gerdj/RedBear/SFP_Extruder/Doc/BOM.pdf

SFP Extruder BOM

Item | QTY
Brass heat insert M3 x 5.7 | 5
Brass heat insert M2.5 x 5.7 | 2
M3 hex nut | 1
M3 square nut | 6
M3 nylock nut | 5
M2 x 8 BHCS screw | 1
M3 x 12 BHCS screw | 4
M3 x 20 BHCS screw | 2
M3 x 16 CS screw | 1
M2.5 x 6 SHCS screw | 2
M3 x 10 SHCS screw | 10
M3 x 18 SHCS screw | 4
M3 x 35 SHCS screw | 2
M3 x 40 SHCS screw | 2
M3 x 50 SHCS screw | 2
Bondtech ballbearing 5x8x2.5 SKU: MR85ZZ | 2
Bondtech shaft assembly SKU: 15021 | 1
Bondtech drivegear kit SKU: EXT-KIT33 | 1
Bondtech motorgear SKU: 15002B | 1
Bondtech thumbscrew SKU: 15026 | 1
PTFE tube >18mm | 1
Prusa i3 MK3 to MK3S upgrade kit Ref: MK3-MK3S-SELF | 1
Mosquito hotend assembled | 1
Nema 17 pancake stepper motor 20 or 25mm | 1
Fan 40x10x10 | 1
Fan blower 5015 | 1
