gerdj/RedBear/SFP_Extruder/CAD/STL/X_Carriage.stl

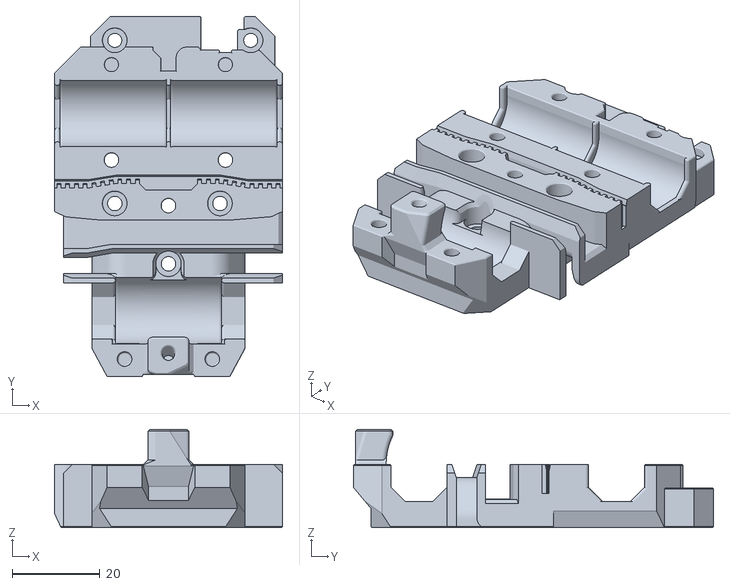
[picture p2: CAD file, 2020-08-03]
SFP_Extruder/CAD/STL/X_Carriage.stl
52.0 x 82.2 x 22.4
