gerdj/RedBear/SFP_Extruder/CAD/STL/Fan_Duct_32.stl

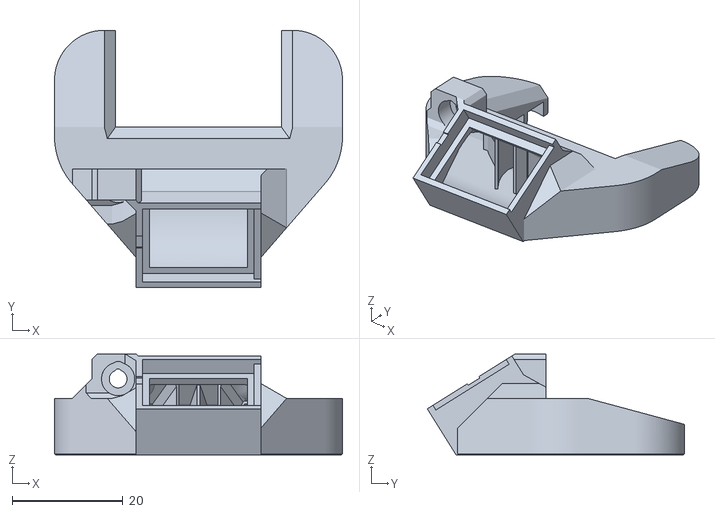
[picture p3: CAD file, 2020-08-03]
SFP_Extruder/CAD/STL/Fan_Duct_32.stl
52.0 x 46.5 x 18.2
