gerdj/RedBear/SFP_Extruder/CAD/STL/X_Carriage_Back.stl

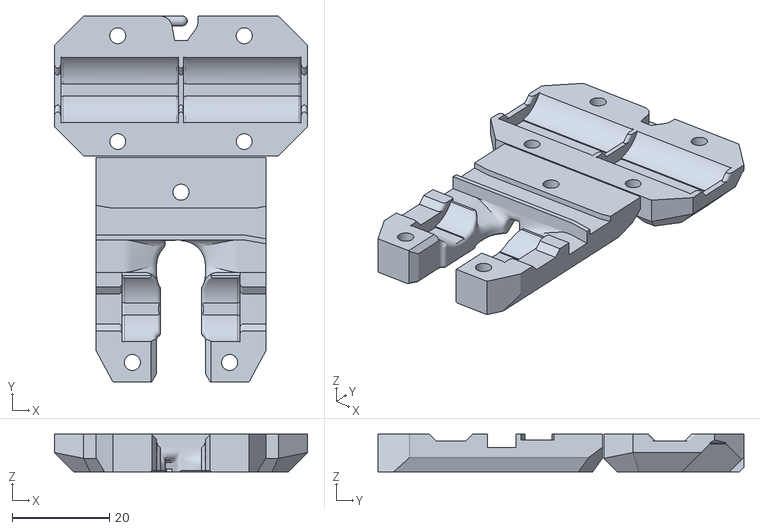
[picture p4: CAD file, 2020-08-03]
SFP_Extruder/CAD/STL/X_Carriage_Back.stl
52.0 x 75.2 x 7.80
