gerdj/RedBear/SFP_Extruder/CAD/STL/Adapter_printer.stl

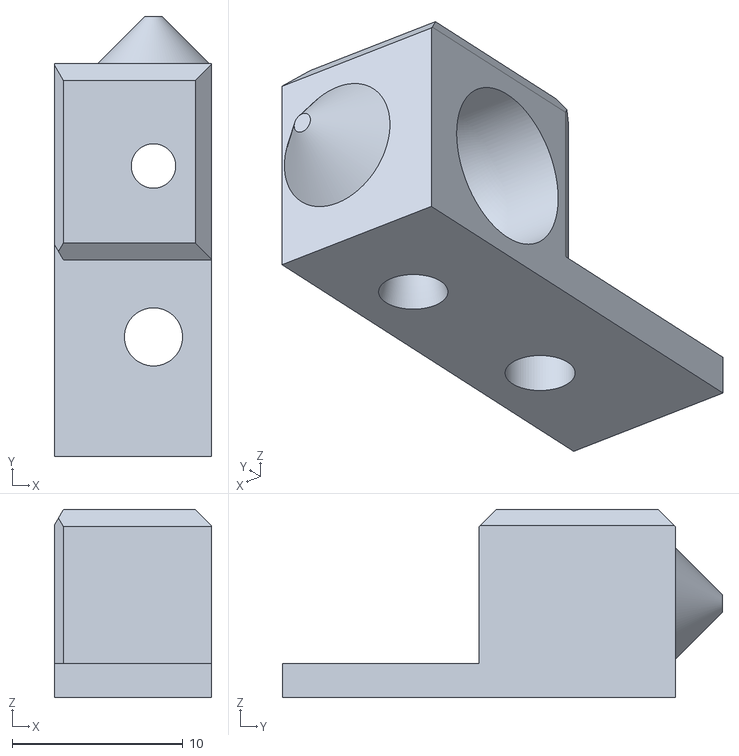
[picture p5: CAD file, 2020-08-03]
SFP_Extruder/CAD/STL/Adapter_printer.stl
9.20 x 25.8 x 11.0
