gerdj/RedBear/SFP_Extruder/CAD/STL/Extruder_Front.stl

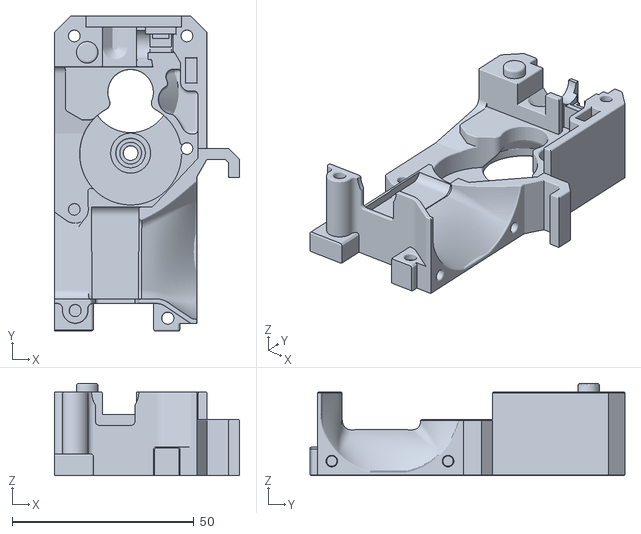
[picture p6: CAD file, 2020-08-03]
SFP_Extruder/CAD/STL/Extruder_Front.stl
51.0 x 86.7 x 25.4
