gerdj/RedBear/SFP_Extruder/CAD/STL/Cable_Guide_Back_A.stl

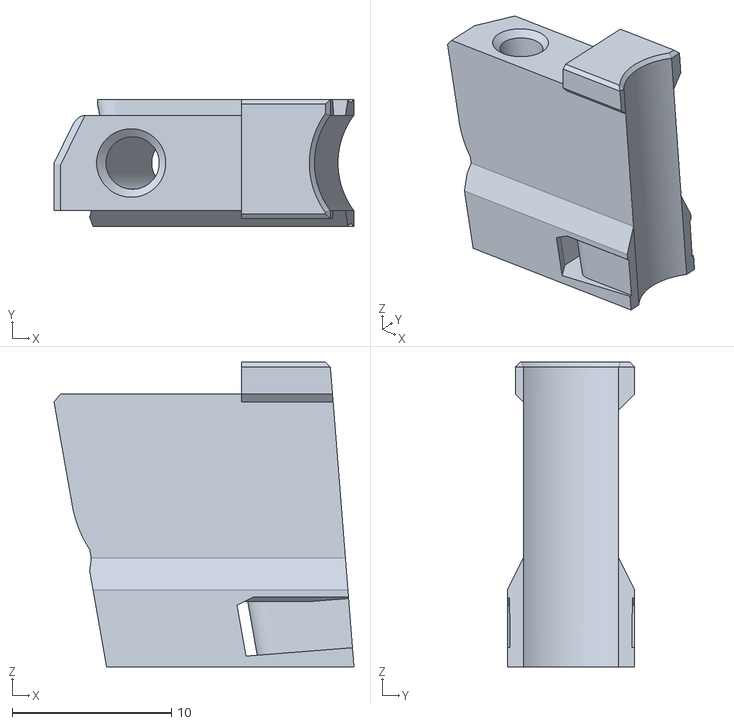
[picture p7: CAD file, 2020-08-03]
SFP_Extruder/CAD/STL/Cable_Guide_Back_A.stl
18.9 x 8.00 x 19.1
