gerdj/RedBear/SFP_Extruder/CAD/STL/FS_Cover_Rev_Bowden_M10.stl

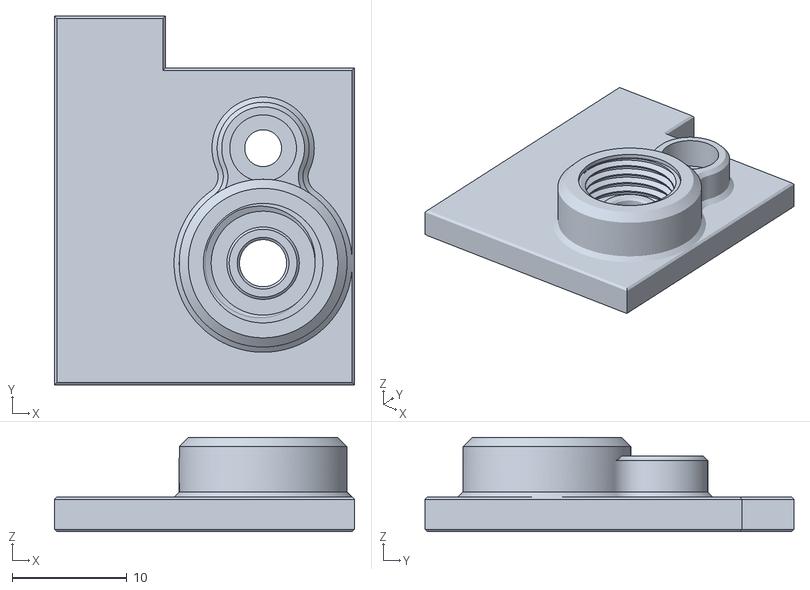
[picture p8: CAD file, 2020-08-03]
SFP_Extruder/CAD/STL/FS_Cover_Rev_Bowden_M10.stl
26.1 x 32.1 x 8.20
