gerdj/RedBear/SFP_Extruder/CAD/STL/Fan_Support_32.stl

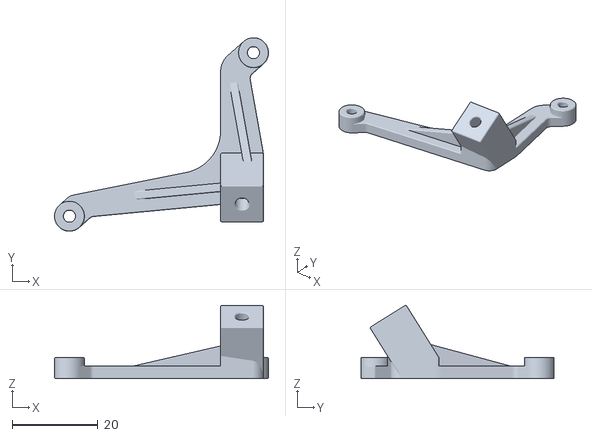
[picture p9: CAD file, 2020-08-03]
SFP_Extruder/CAD/STL/Fan_Support_32.stl
50.0 x 45.2 x 17.2
