gerdj/RedBear/SFP_Extruder/CAD/STL/FS_Cover.stl

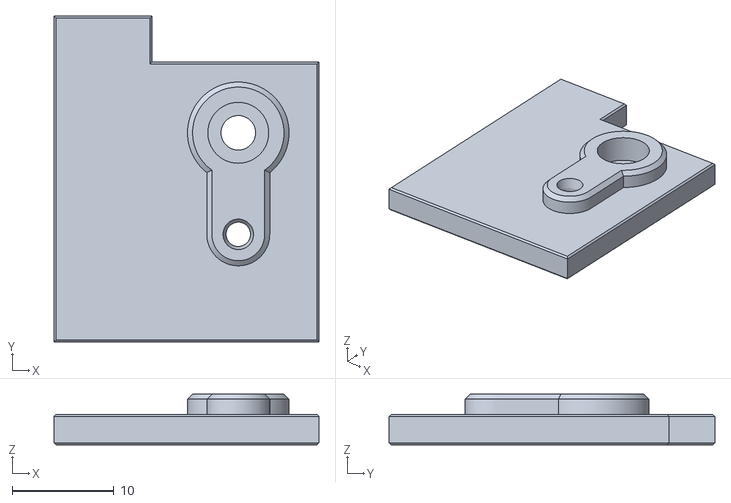
[picture p10: CAD file, 2020-08-03]
SFP_Extruder/CAD/STL/FS_Cover.stl
26.1 x 32.1 x 5.00
