gerdj/RedBear/SFP_Extruder/CAD/STL/FS_Lever.stl

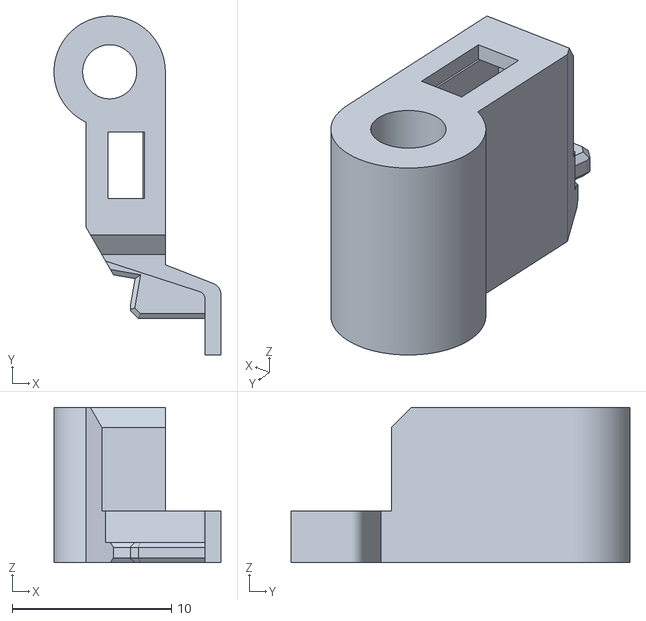
[picture p11: CAD file, 2020-08-03]
SFP_Extruder/CAD/STL/FS_Lever.stl
10.5 x 21.3 x 9.75
