gerdj/RedBear/SFP_Extruder/CAD/STL/Cable_Guide_Back_B.stl

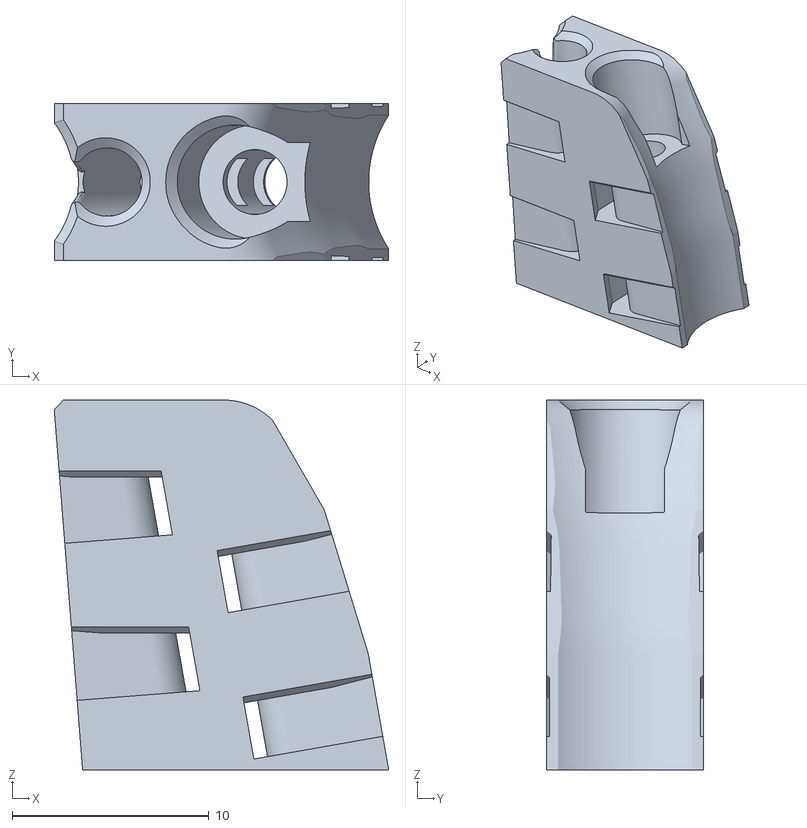
[picture p12: CAD file, 2020-08-03]
SFP_Extruder/CAD/STL/Cable_Guide_Back_B.stl
17.0 x 8.00 x 18.8
