gerdj/RedBear/SFP_Extruder/CAD/STL/Extruder_Idler.stl

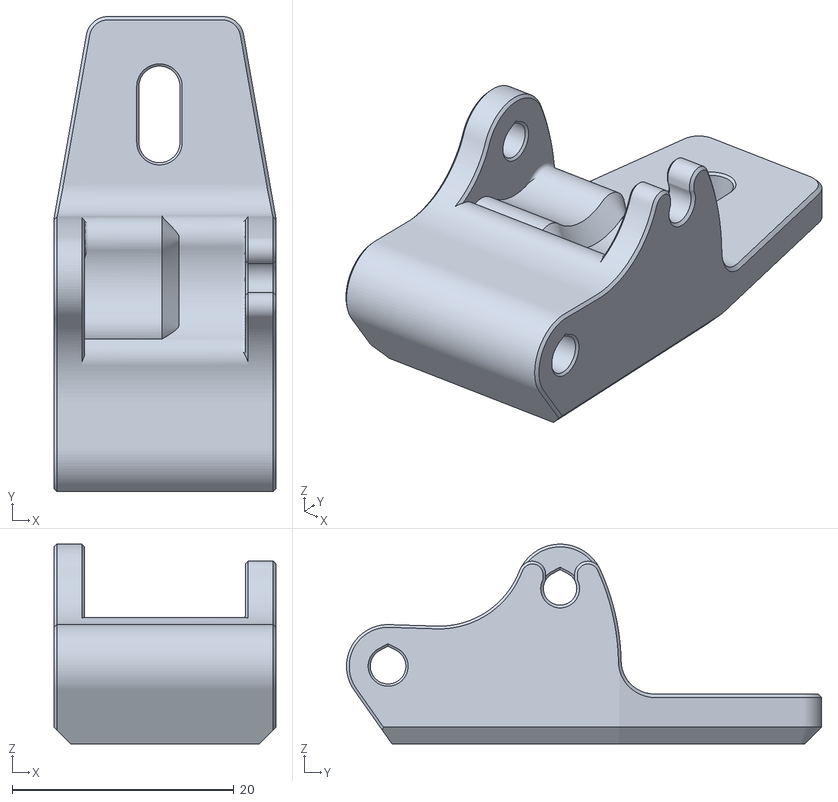
[picture p13: CAD file, 2020-08-03]
SFP_Extruder/CAD/STL/Extruder_Idler.stl
20.0 x 42.8 x 18.0
