gerdj/RedBear/SFP_Extruder/CAD/STL/Extruder_Base.stl

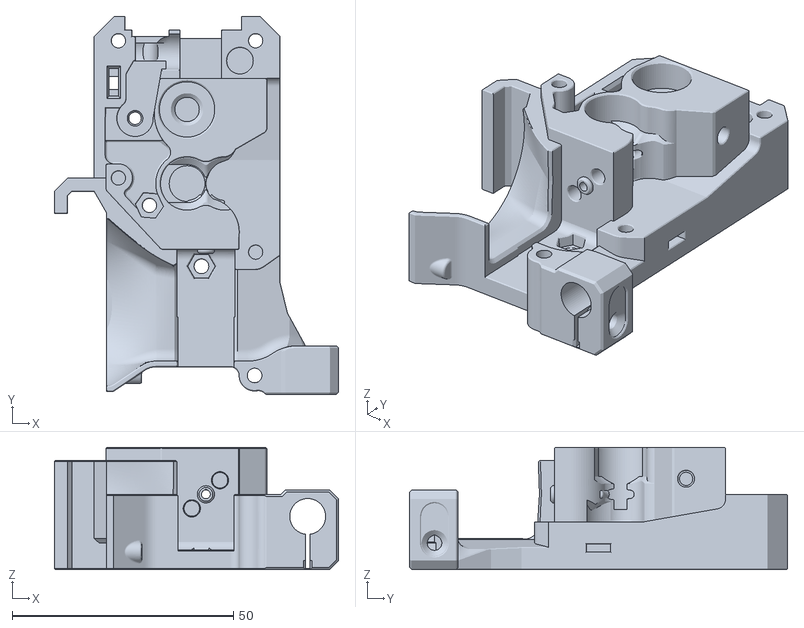
[picture p14: CAD file, 2020-08-03]
SFP_Extruder/CAD/STL/Extruder_Base.stl
64.2 x 85.4 x 27.6
