gerdj/RedBear/SFP_Extruder/Doc/SFP_Extruder_Assembly.pdf

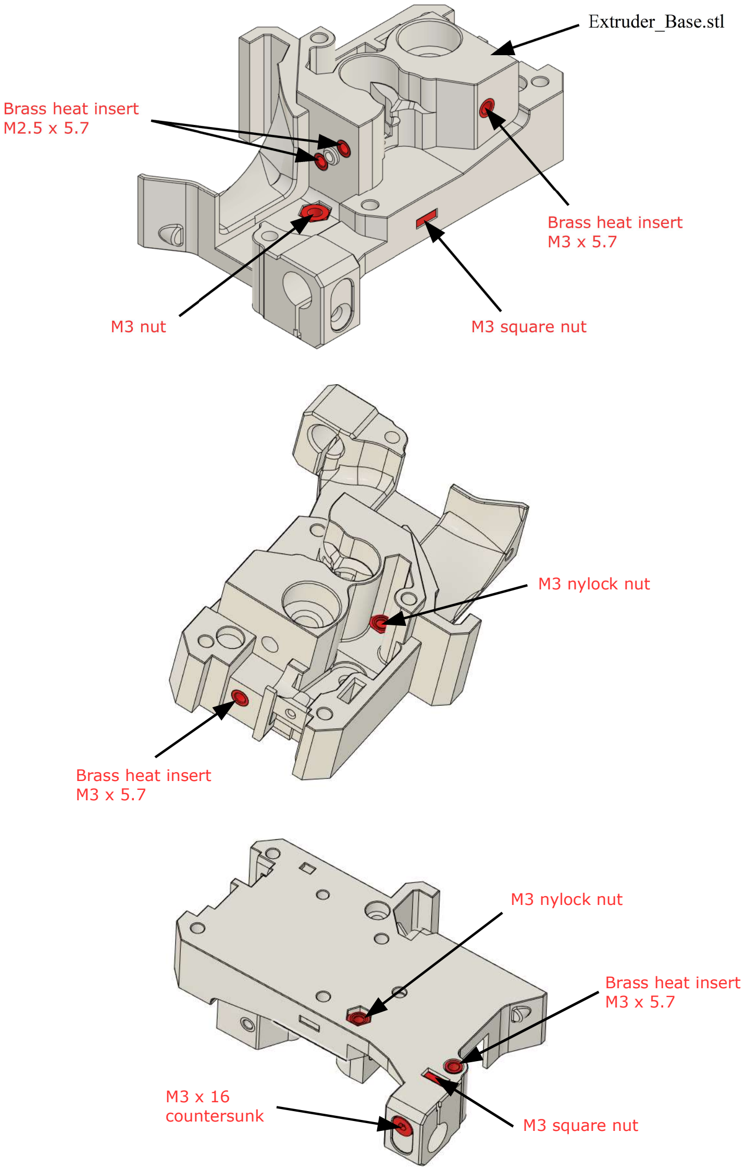
[picture p15: page 1]

Brass heat insert
M3 x 5.7

M3 nylock nut

M3 nylock nut

M3 x 16

countersunk | M3 square nut Brass heat insert
| M3 x 5.7

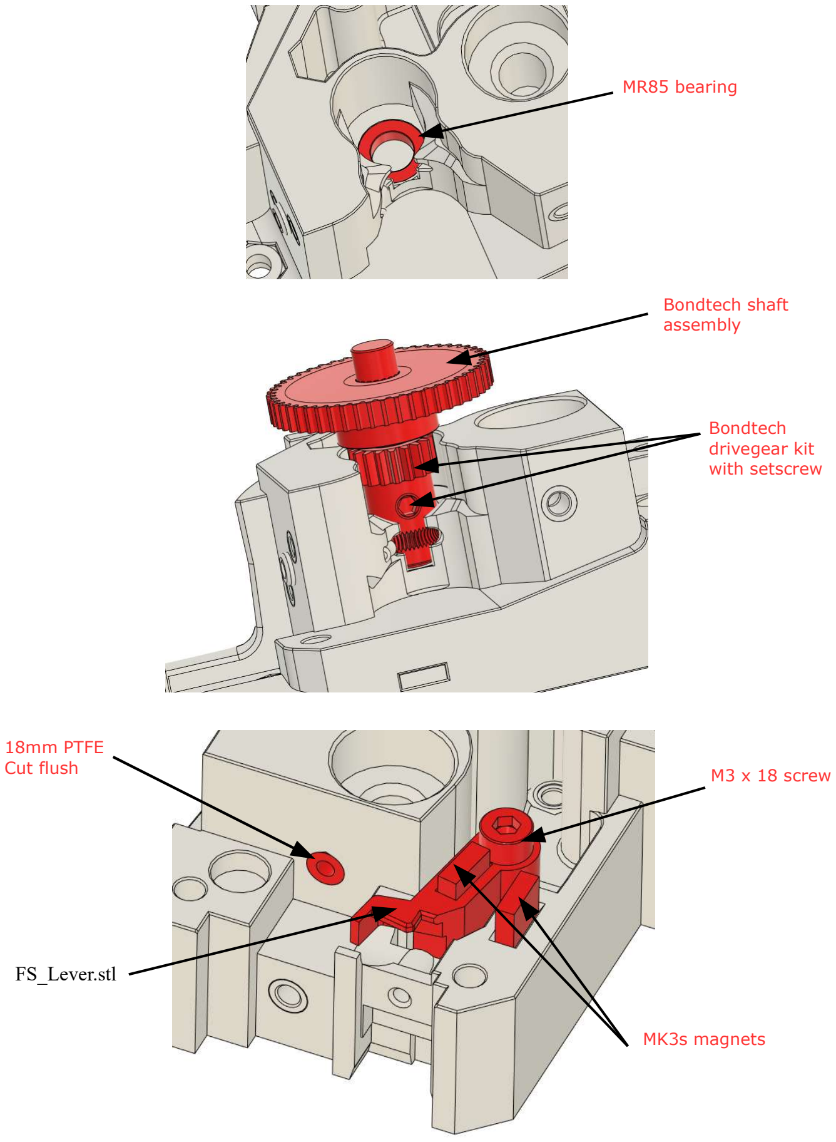
[picture p16: page 2]

MR85 bearing

Bondtech shaft
assembly

Bondtech
drivegear kit
with setscrew

M3 x 18 screw

MK3s magnets

18mm PTFE
Cut flush

FS_Lever.stl

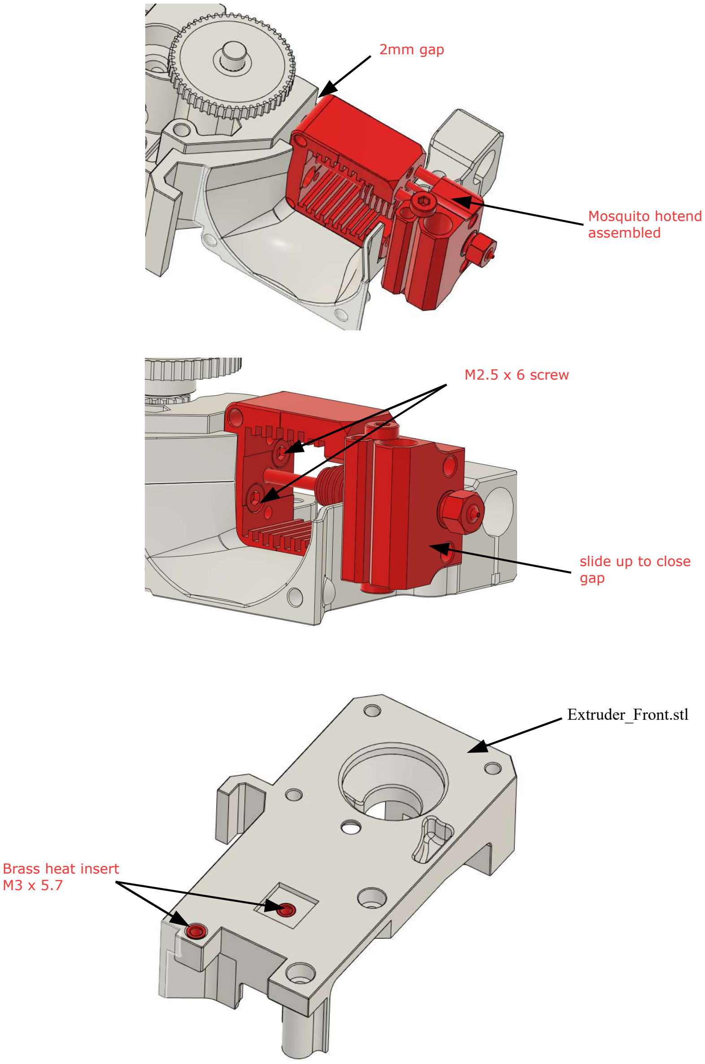
[picture p17: page 3]

Mosquito hotend
assembled

2mm gap

M2.5 x 6 screw

slide up to close
gap

Extruder_Front.stl

Brass heat insert
M3 x 5.7

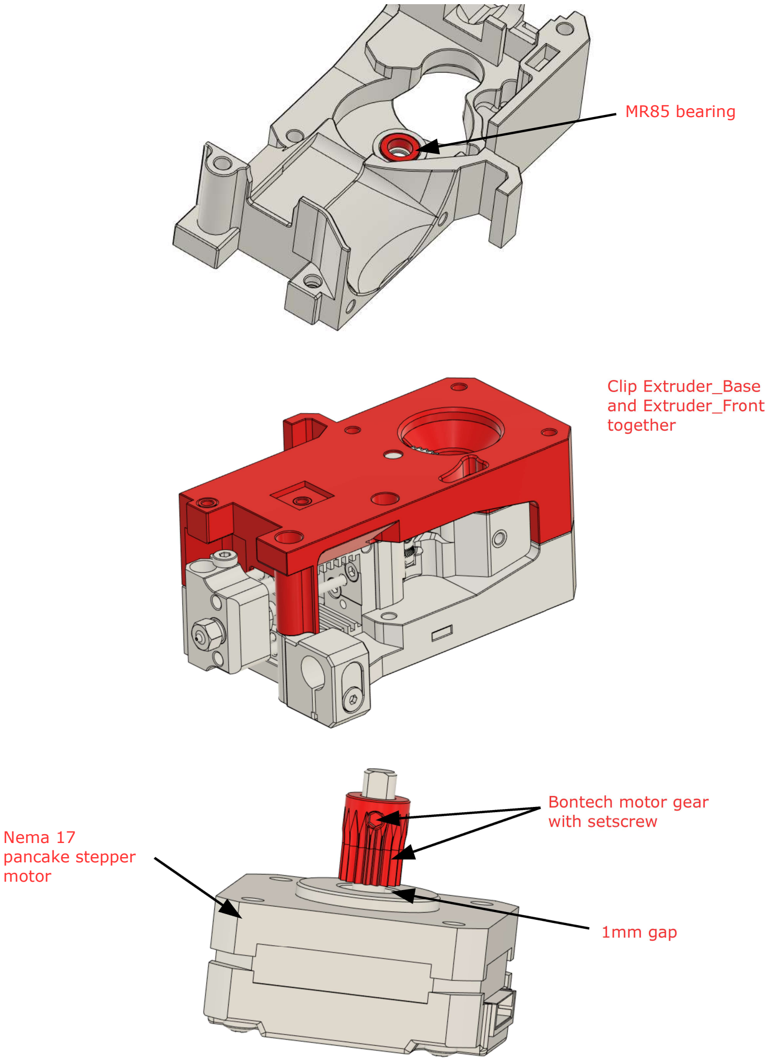
[picture p18: page 4]

MR85 bearing

Nema 17
pancake stepper
motor

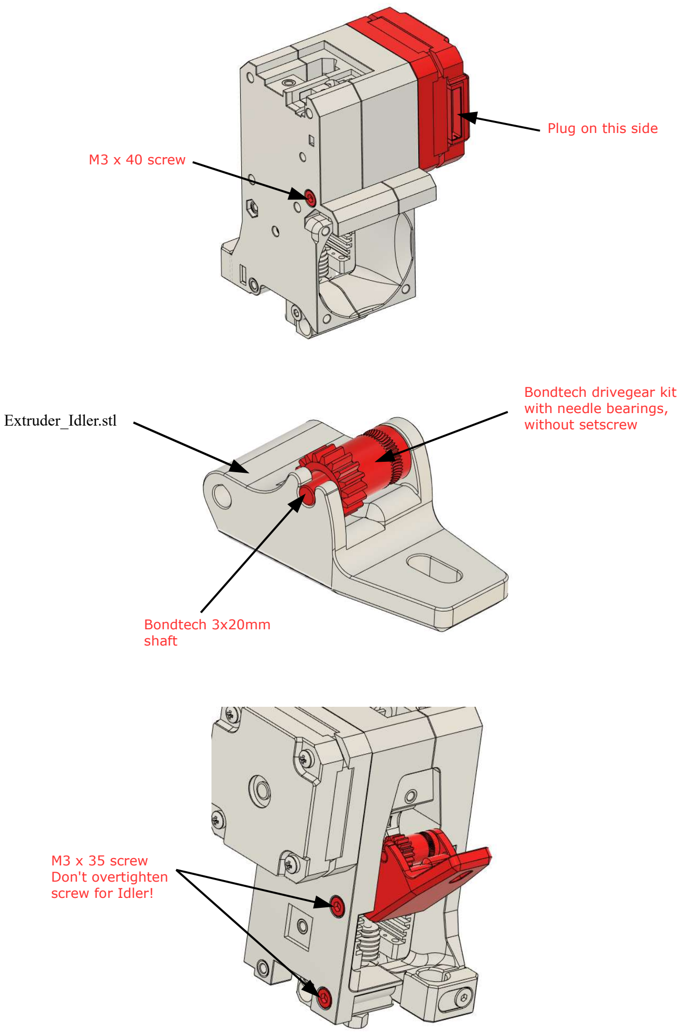
[picture p19: page 5]

Plug on this side

M3 x 40 screw

Extruder_Idler.stl

Bondtech drivegear kit
with needle bearings,
without setscrew

Bondtech 3x20mm
shaft

M3 x 35 screw
Don't overtighten
screw for Idler!

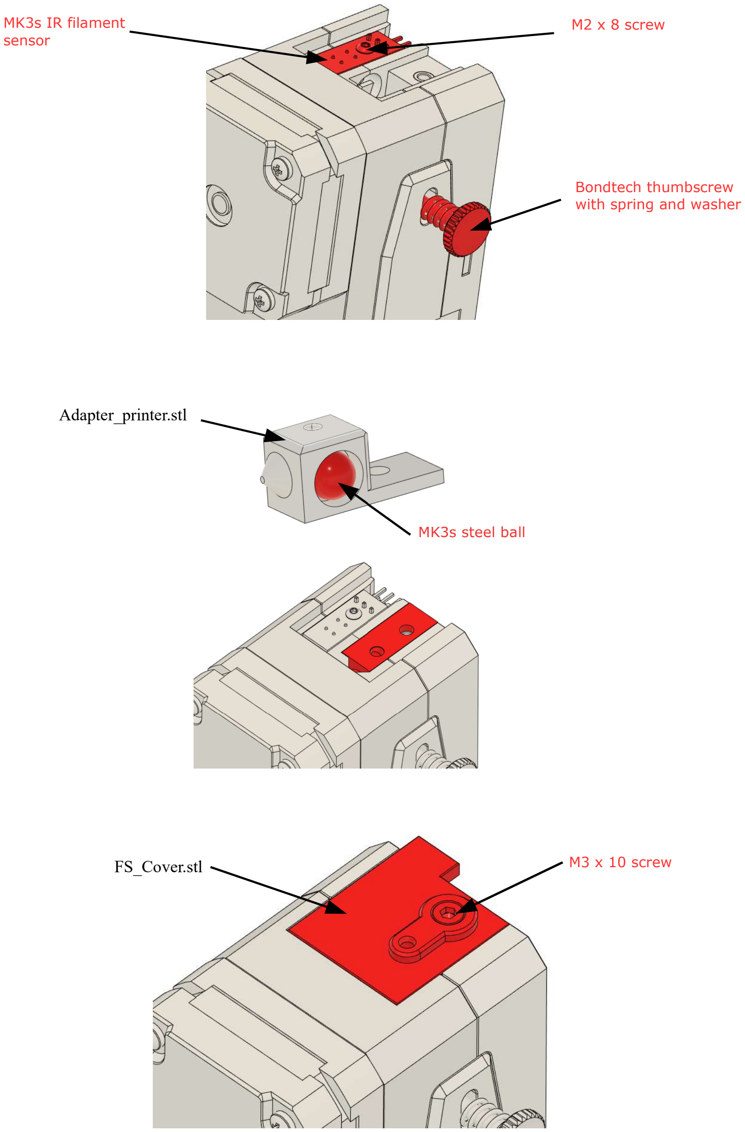
[picture p20: page 6]

MK3s IR filament
sensor

M2 x 8 screw

Bondtech thumbscrew
with spring and washer

Adapter_printer.stl

FS_Cover.stl | M3 x 10 screw

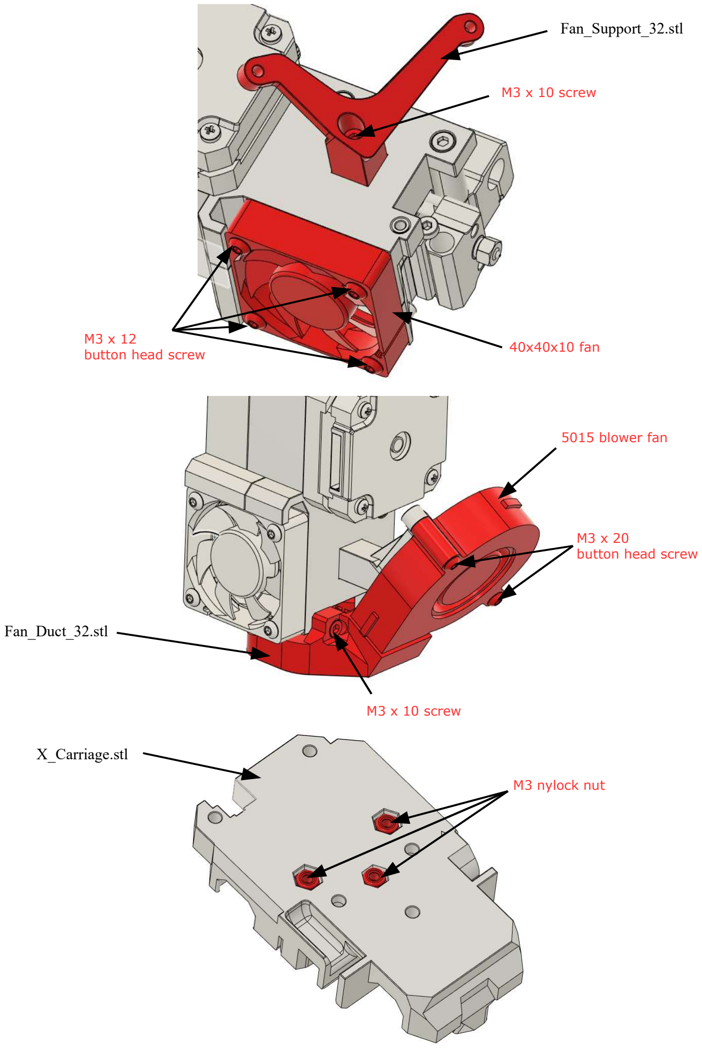
[picture p21: page 7]

Fan_Support_32.stl

M3 x 10 screw

M3 x 12
button head screw | 40x40x10 fan

Fan_Duct_32.stl

M3 x 20
button head screw

5015 blower fan

M3 x 10 screw

^

X_Carriage.stl

M3 nylock nut

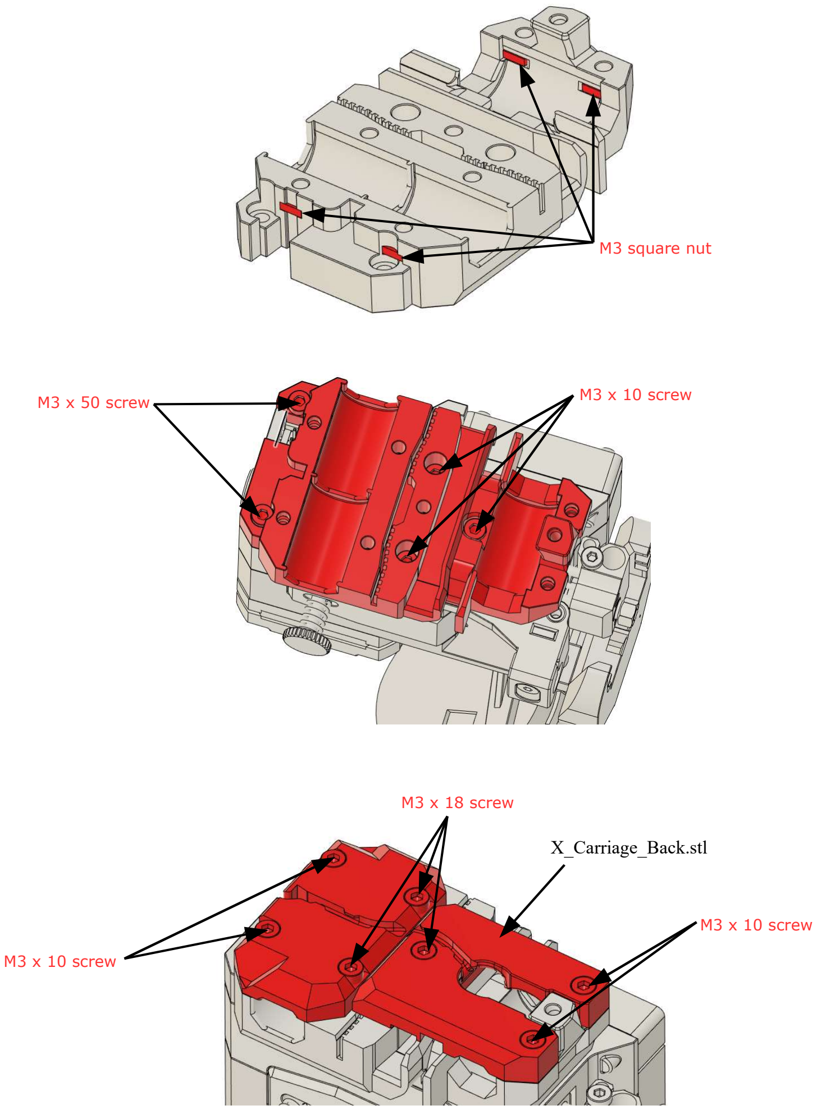
[picture p22: page 8]

M3 square nut

M3 x 10 screw M3 x 50 screw

M3 x 10 screw

M3 x 18 screw

X_Carriage_Back.stl

M3 x 10 screw

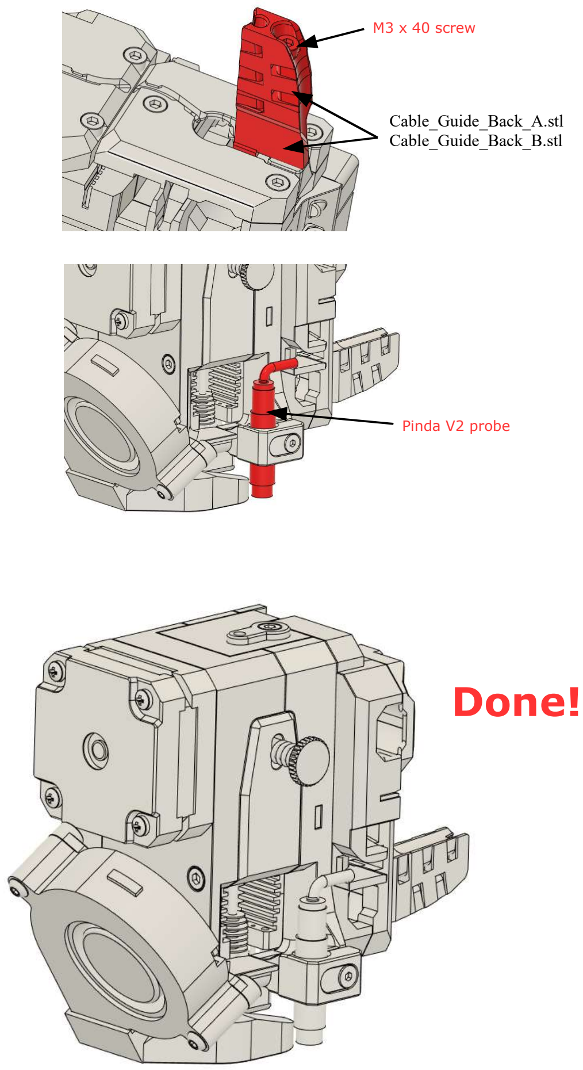
[picture p23: page 9]

M3 x 40 screw

Cable_Guide_Back_A.stl
Cable_Guide_Back_B.stl

Pinda V2 probe

# Done!
