gerdj/RedBear/Firmware/2.0.6/Marlin/Configuration_adv.h

#define E0_AUTO_FAN_PIN P2_04
#define E1_AUTO_FAN_PIN -1
#define E2_AUTO_FAN_PIN -1
#define E3_AUTO_FAN_PIN -1
#define E4_AUTO_FAN_PIN -1
#define E5_AUTO_FAN_PIN -1
#define E6_AUTO_FAN_PIN -1
#define E7_AUTO_FAN_PIN -1
#define CHAMBER_AUTO_FAN_PIN -1
#define HOMING_BUMP_MM      { 0, 0, 2 }       // (mm) Backoff from endstops after first bump
#define HOMING_BUMP_DIVISOR { 2, 2, 4 }       // Re-Bump Speed Divisor (Divides the Homing Feedrate)
#define HOMING_BACKOFF_POST_MM { 2, 2, 2 }  // (mm) Backoff from endstops after homing
#define QUICK_HOME                          // If G28 contains XY do a diagonal move first
  #define HOME_AFTER_G34
#define MICROSTEP_MODES { 16, 16, 16, 16, 16, 16 } // [1,2,4,8,16]
#define LIN_ADVANCE
  #define LIN_ADVANCE_K 0.00    // Unit: mm compression per 1mm/s extruder speed
#define ADVANCED_PAUSE_FEATURE
  #define ADVANCED_PAUSE_PURGE_FEEDRATE        3  // (mm/s) Extrude feedrate (after loading). Should be slower than load feedrate.
  #define ADVANCED_PAUSE_PURGE_LENGTH         30  // (mm) Length to extrude after loading.
  #define ADVANCED_PAUSE_RESUME_PRIME          0  // (mm) Extra distance to prime nozzle after returning from park.
  #define ADVANCED_PAUSE_FANS_PAUSE             // Turn off print-cooling fans while the machine is paused.
    #define X_CURRENT       500        // (mA) RMS current. Multiply by 1.414 for peak current.
    #define X_CURRENT_HOME  200  // (mA) RMS current for sensorless homing
    #define X_MICROSTEPS     16    // 0..256
    #define Y_CURRENT       600
    #define Y_CURRENT_HOME  250
    #define Y_MICROSTEPS     16
    #define Z_CURRENT       450
    #define Z_CURRENT_HOME  Z_CURRENT
    #define Z_MICROSTEPS     16
    #define Z2_CURRENT      450
    #define Z2_CURRENT_HOME Z2_CURRENT
    #define Z2_MICROSTEPS    16
    #define E0_CURRENT      550
    #define E0_MICROSTEPS    32
  #define X_HYBRID_THRESHOLD     100  // [mm/s]
  #define X2_HYBRID_THRESHOLD    100
  #define Y_HYBRID_THRESHOLD     100
  #define Y2_HYBRID_THRESHOLD    100
  #define Z_HYBRID_THRESHOLD       3
  #define Z2_HYBRID_THRESHOLD      3
  #define Z3_HYBRID_THRESHOLD      3
  #define Z4_HYBRID_THRESHOLD      3
  #define E0_HYBRID_THRESHOLD     30
  #define E1_HYBRID_THRESHOLD     30
  #define E2_HYBRID_THRESHOLD     30
  #define E3_HYBRID_THRESHOLD     30
  #define E4_HYBRID_THRESHOLD     30
  #define E5_HYBRID_THRESHOLD     30
  #define E6_HYBRID_THRESHOLD     30
  #define E7_HYBRID_THRESHOLD     30
  #define SENSORLESS_HOMING // StallGuard capable drivers only
    #define X_STALL_SENSITIVITY  100
    #define X2_STALL_SENSITIVITY X_STALL_SENSITIVITY
    #define Y_STALL_SENSITIVITY  100
    #define Y2_STALL_SENSITIVITY Y_STALL_SENSITIVITY
    #define IMPROVE_HOMING_RELIABILITY
   #define TMC_HOME_PHASE { 896, 896, -1 }
