gerdj/RedBear/(commit log)

2020-07-31 Marlin 2.0.6
    [Configuration.h, Configuration_adv.h]
2020-08-03 STL files uploaded
    [Adapter_printer.stl, Cable_Guide_Back.stl, Cable_Guide_Back_A.stl, Cable_Guide_Back_B.stl, Extruder_Base.stl, Extruder_Front.stl, Extruder_Idler.stl, FS_Cover.stl]
2020-08-03 Assembly guide uploaded.
    [Adapter_printer.stl, Cable_Guide_Back_A.stl, Cable_Guide_Back_B.stl, Extruder_Base.stl, Extruder_Front.stl, Extruder_Idler.stl, FS_Cover.stl, FS_Cover_Rev_Bowden_M10.stl]
2020-08-04 BOM added
